MubashirHu/filament-sensor-project/doc/project-schematic.pdf

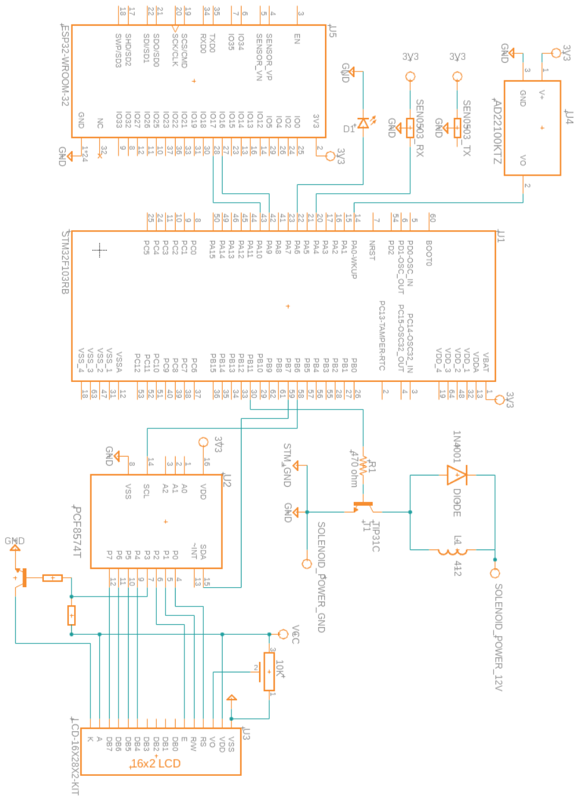
[picture p9: page 1]
