MubashirHu/filament-sensor-project/doc/Schematic Design_ discoveryvl_carrier2016.pdf

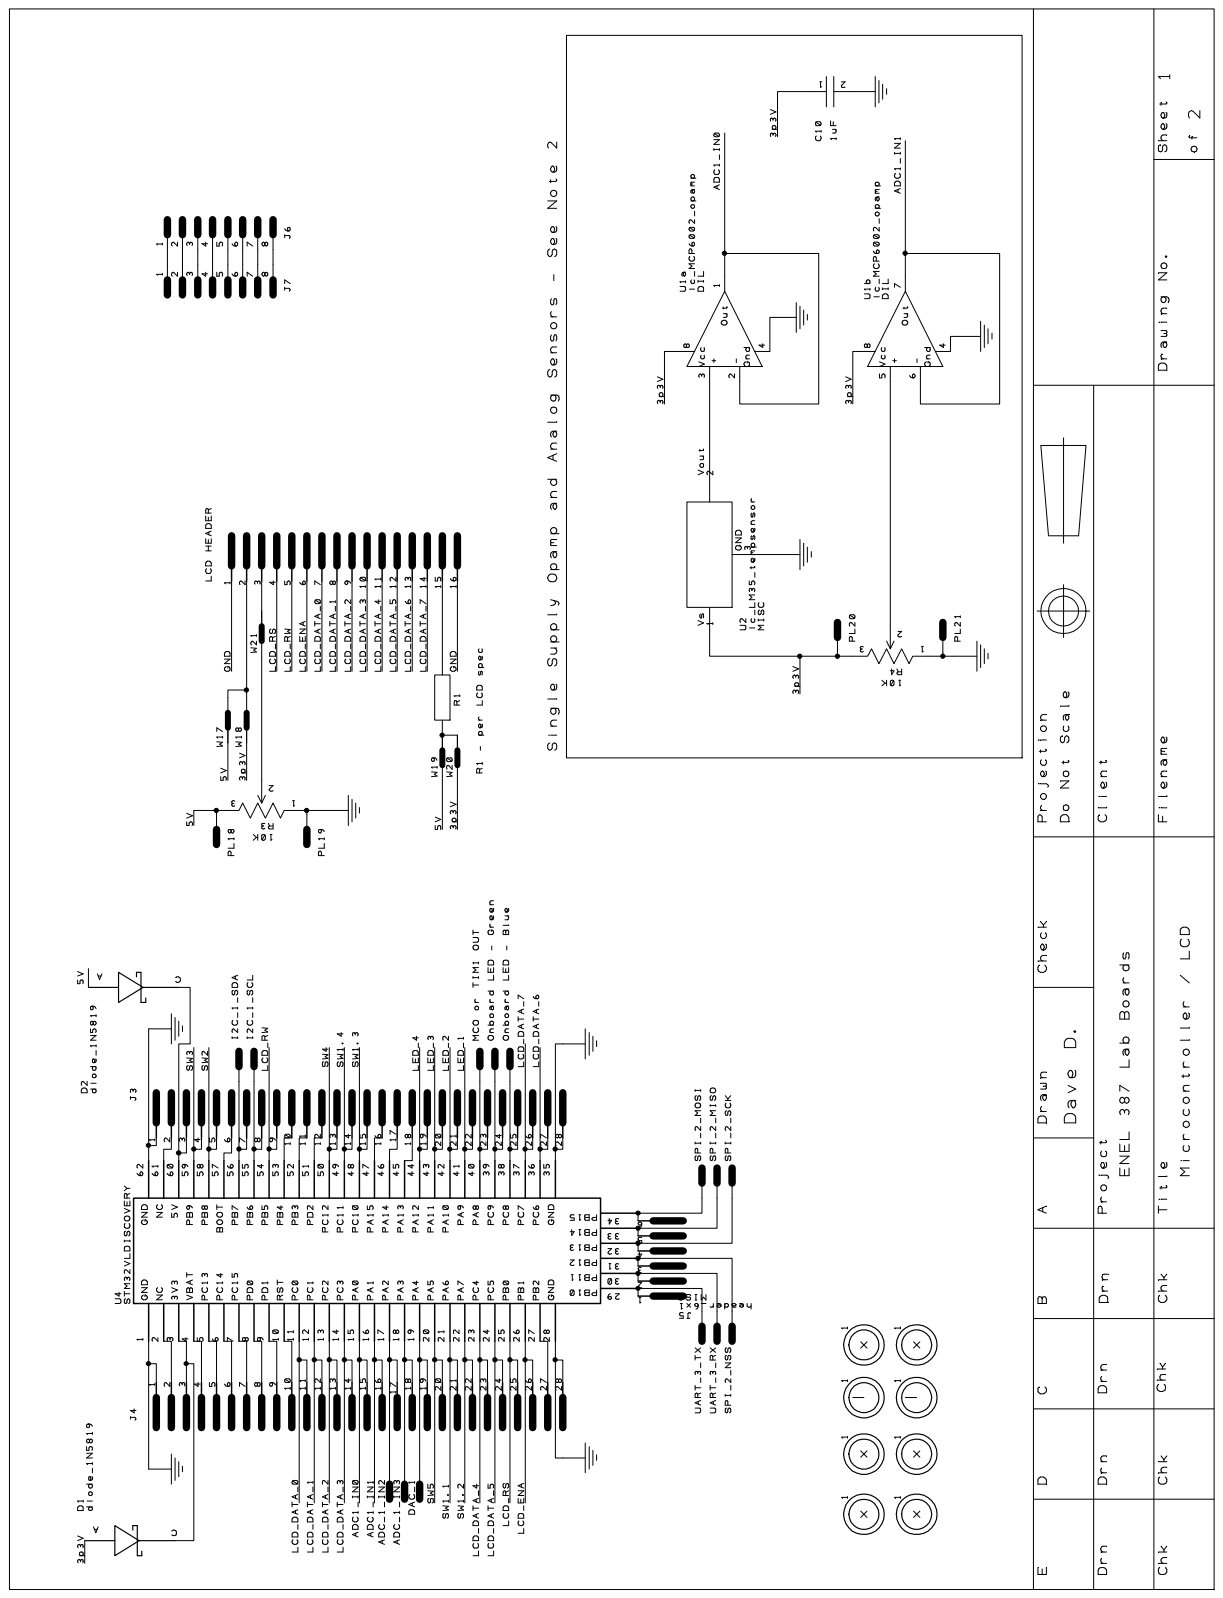
[picture p10: page 1]

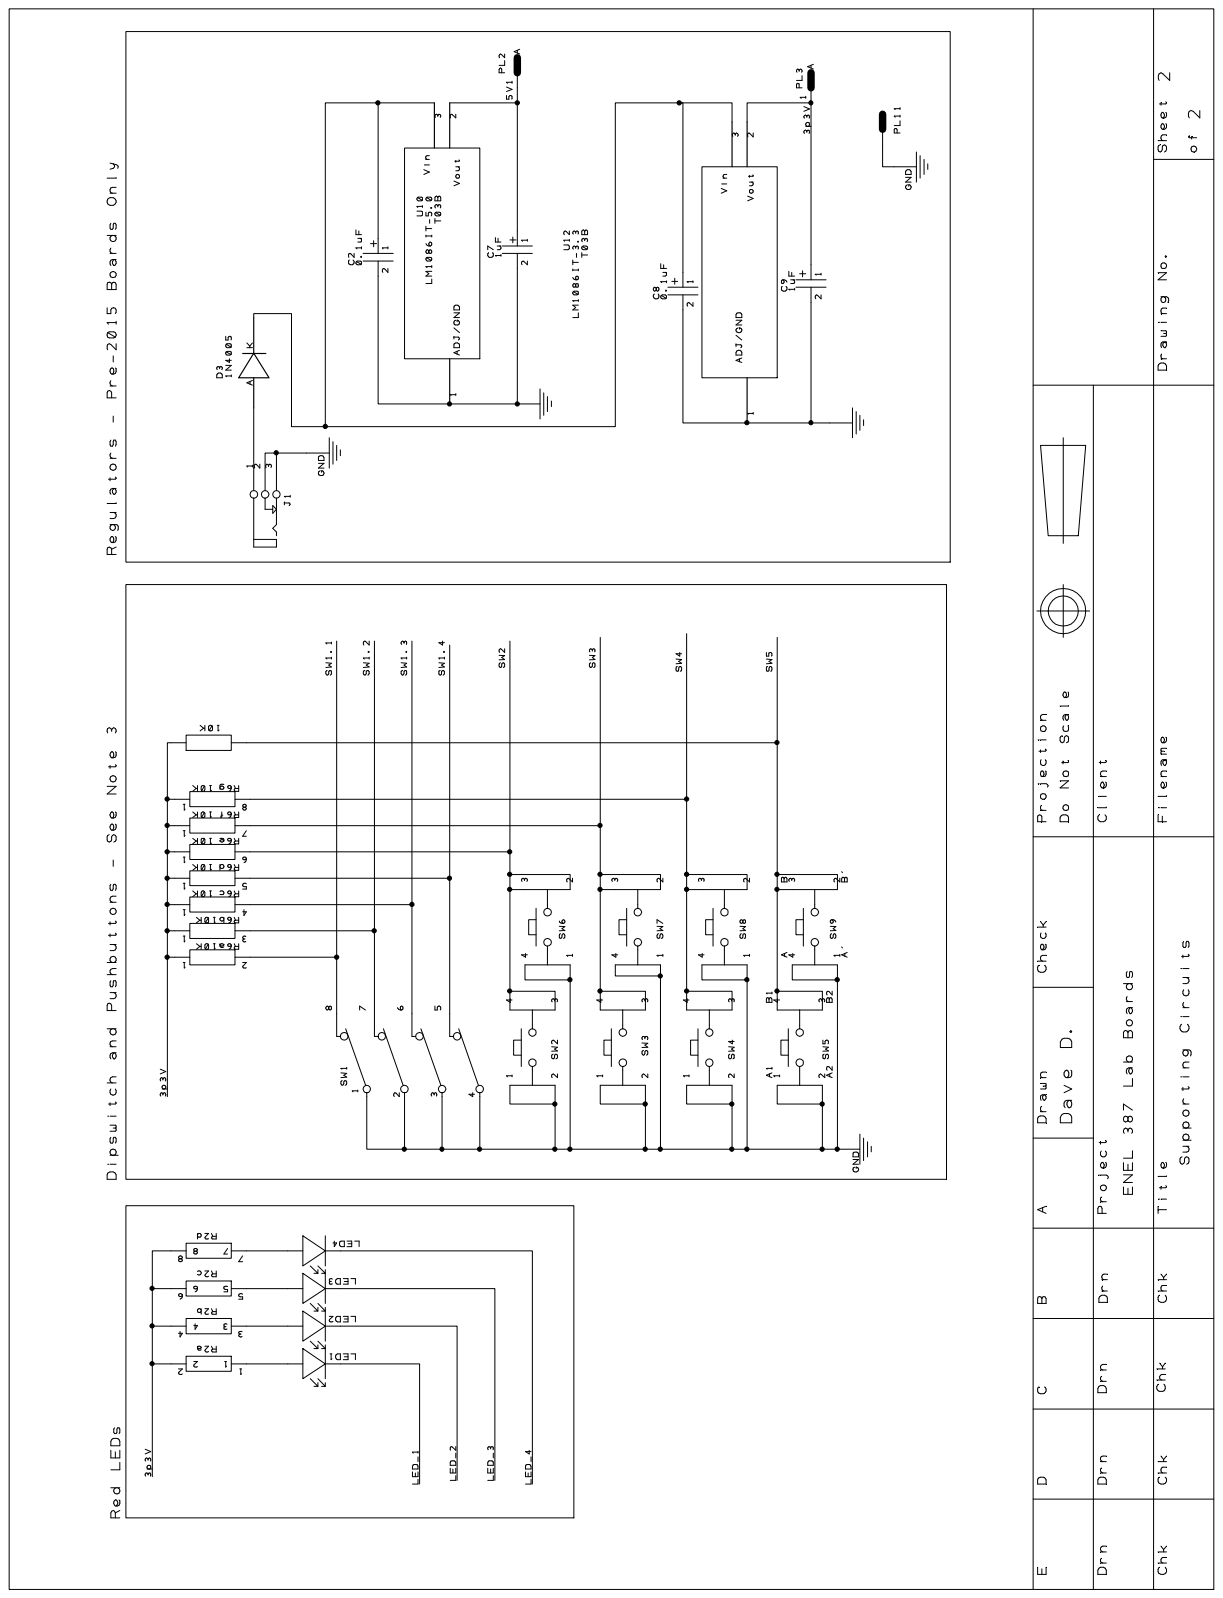
[picture p11: page 2]
