MubashirHu/filament-sensor-project/(commit log)

2023-03-13 able to read IR sensor
2023-03-13 IR and solenoid are functional
2023-03-15 Temperature sensor and LCD are completed
2023-03-26 added working UARTwifi ino file
2023-03-26 untested UARTWIFI to solenoid
2023-03-31 I2C_LCD functional
2023-04-04 added PWM LED
